lulis/malajo/docs/diag_hidraulico.pdf

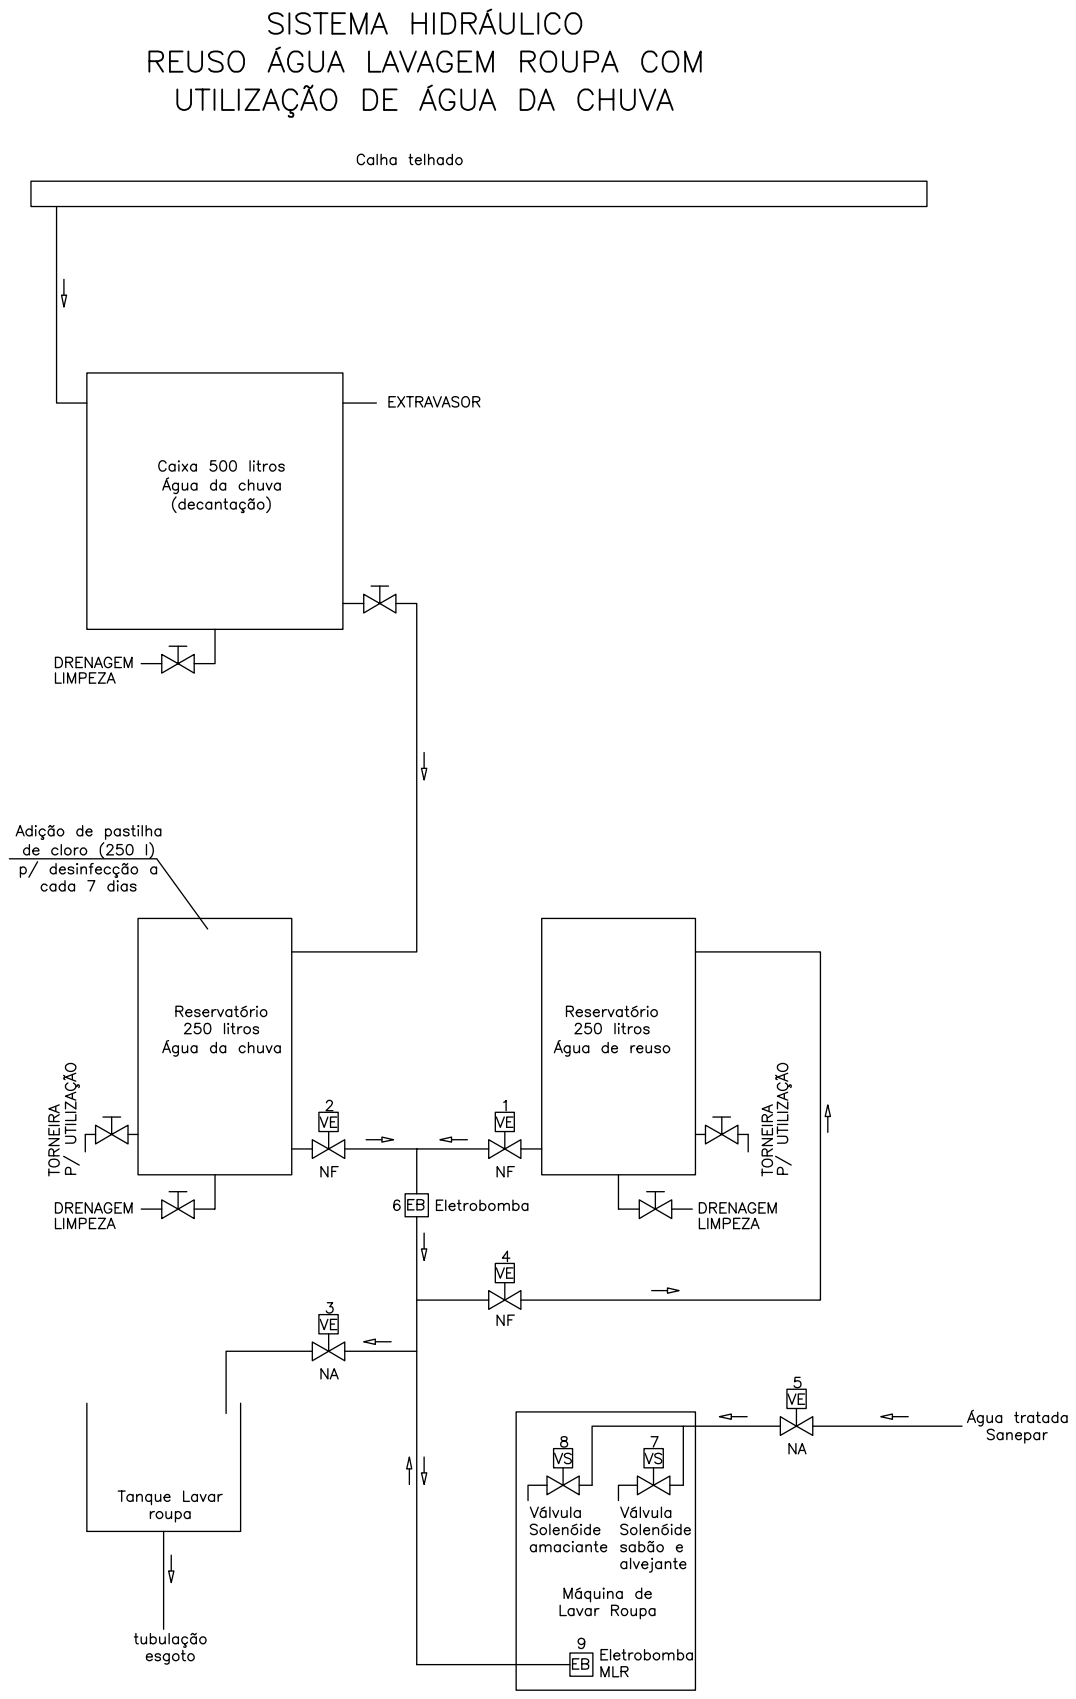
[picture p2: page 1]
