lulis/malajo/docs/diag_eletrico.pdf

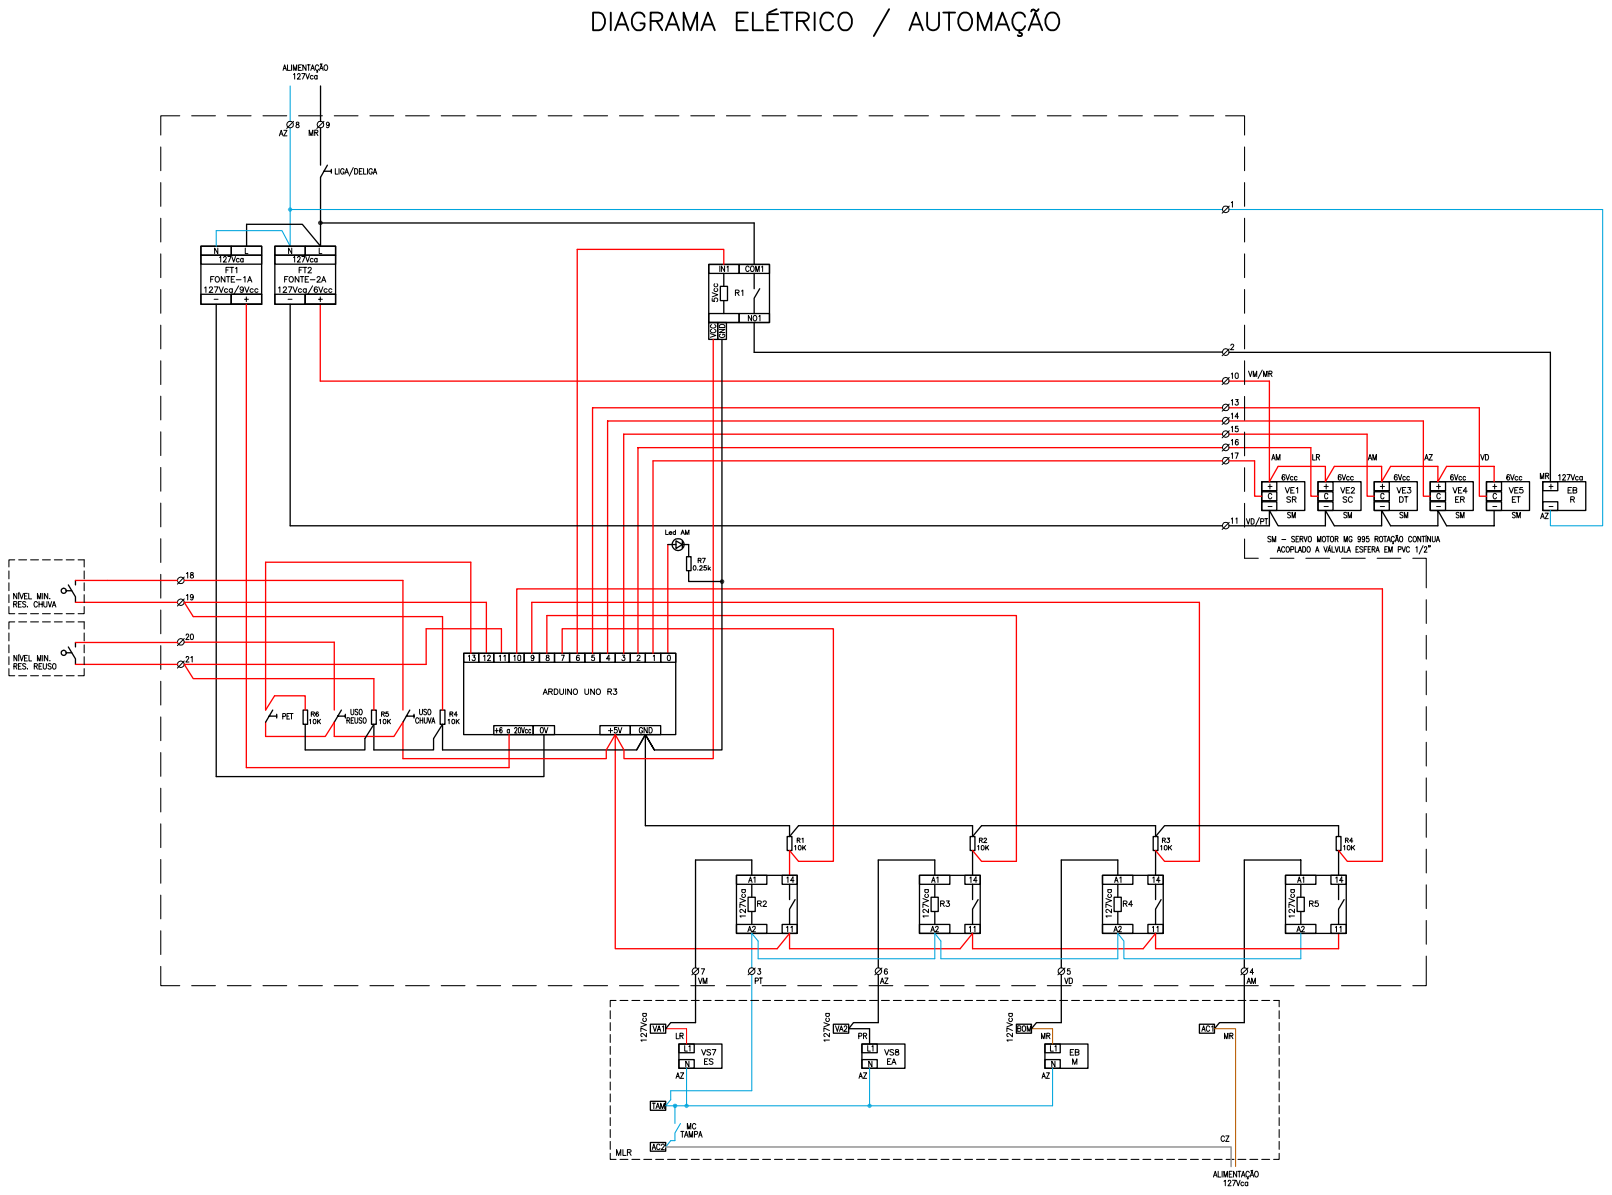
[picture p3: page 1]
