lulis/malajo/(commit log)

2021-07-25 altera liga/desliga para nao forcar valvulas automaticamente
2021-07-25 chaveamento automatico de entradas de agua dureante enchimentos
2021-07-29 reavalia entrada de agua em e2 e e7, cuidando pra nao desligar vs5 inadvertidamente
2021-08-15 adiciona sensores ao overview
2021-08-15 adiciona diagramas. corrige nomenclatura agua da rede
    [malajo.ino]
2021-09-26 refatora salvamento de status para abertura de tampa
2021-09-26 reinicia tempo de dispenser apos fechamento tampa
2021-09-26 fix reinicio tempo de dispenser
    [malajo.ino]
2021-09-28 recalcula tempo troca estado entre abertura de tampa, fix tempo dispenser
    [malajo.ino]
